zachmorr/f1c200s/hardware/f1c200s.pdf

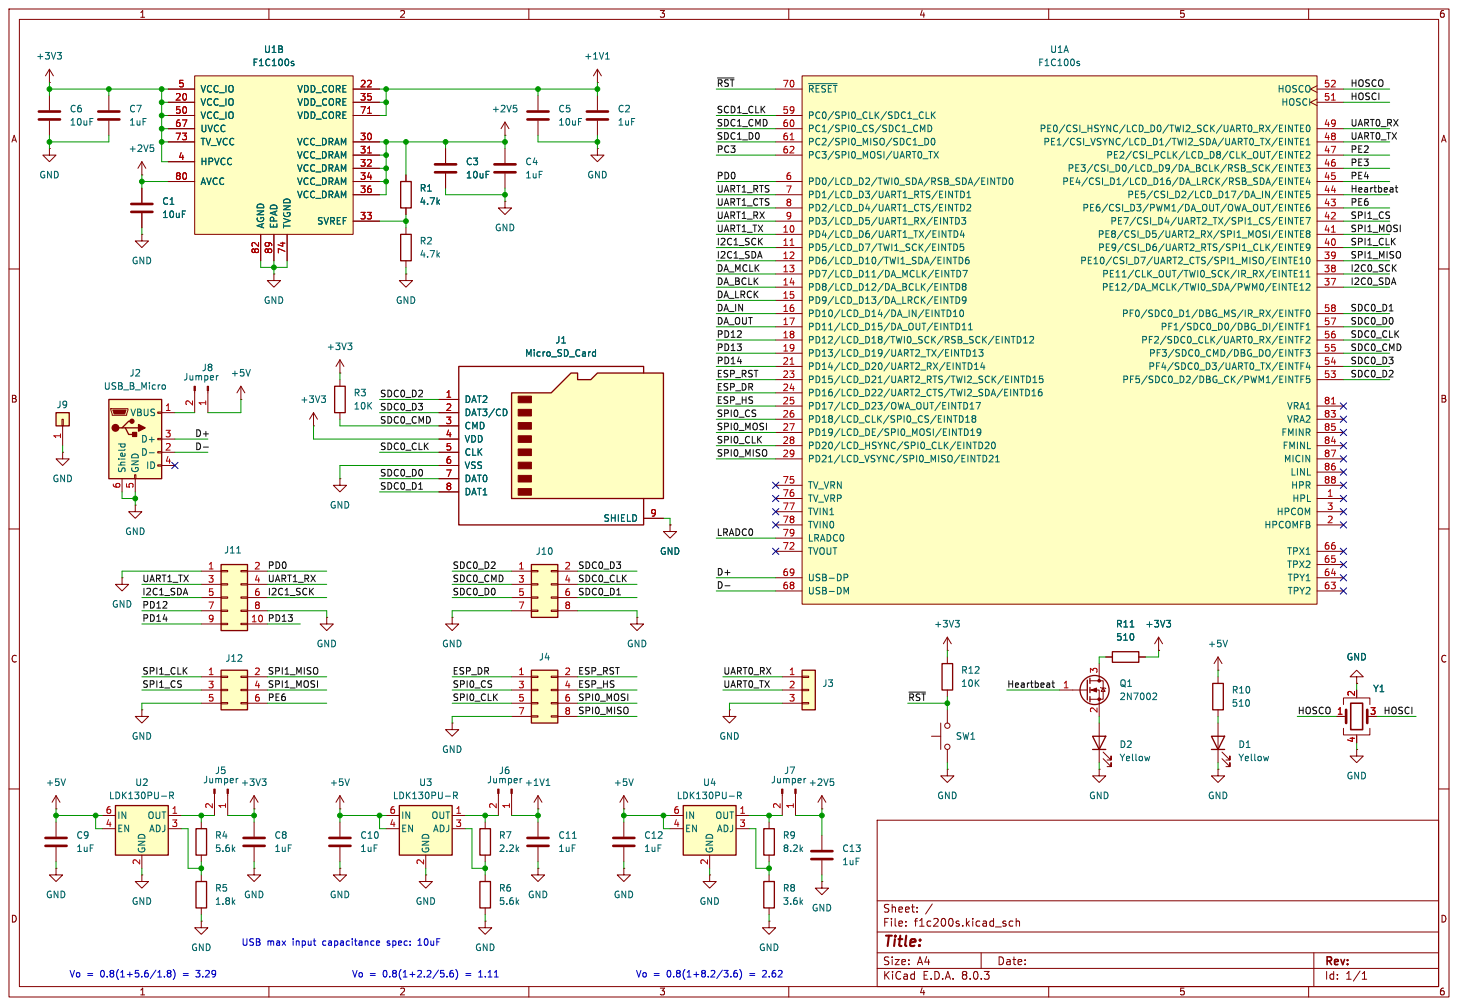
[picture p1: page 1]
