zachmorr/f1c200s/hardware/f1c200s.kicad_pcb

## KiCad design hardware/f1c200s.kicad_pcb (2024-10-19)

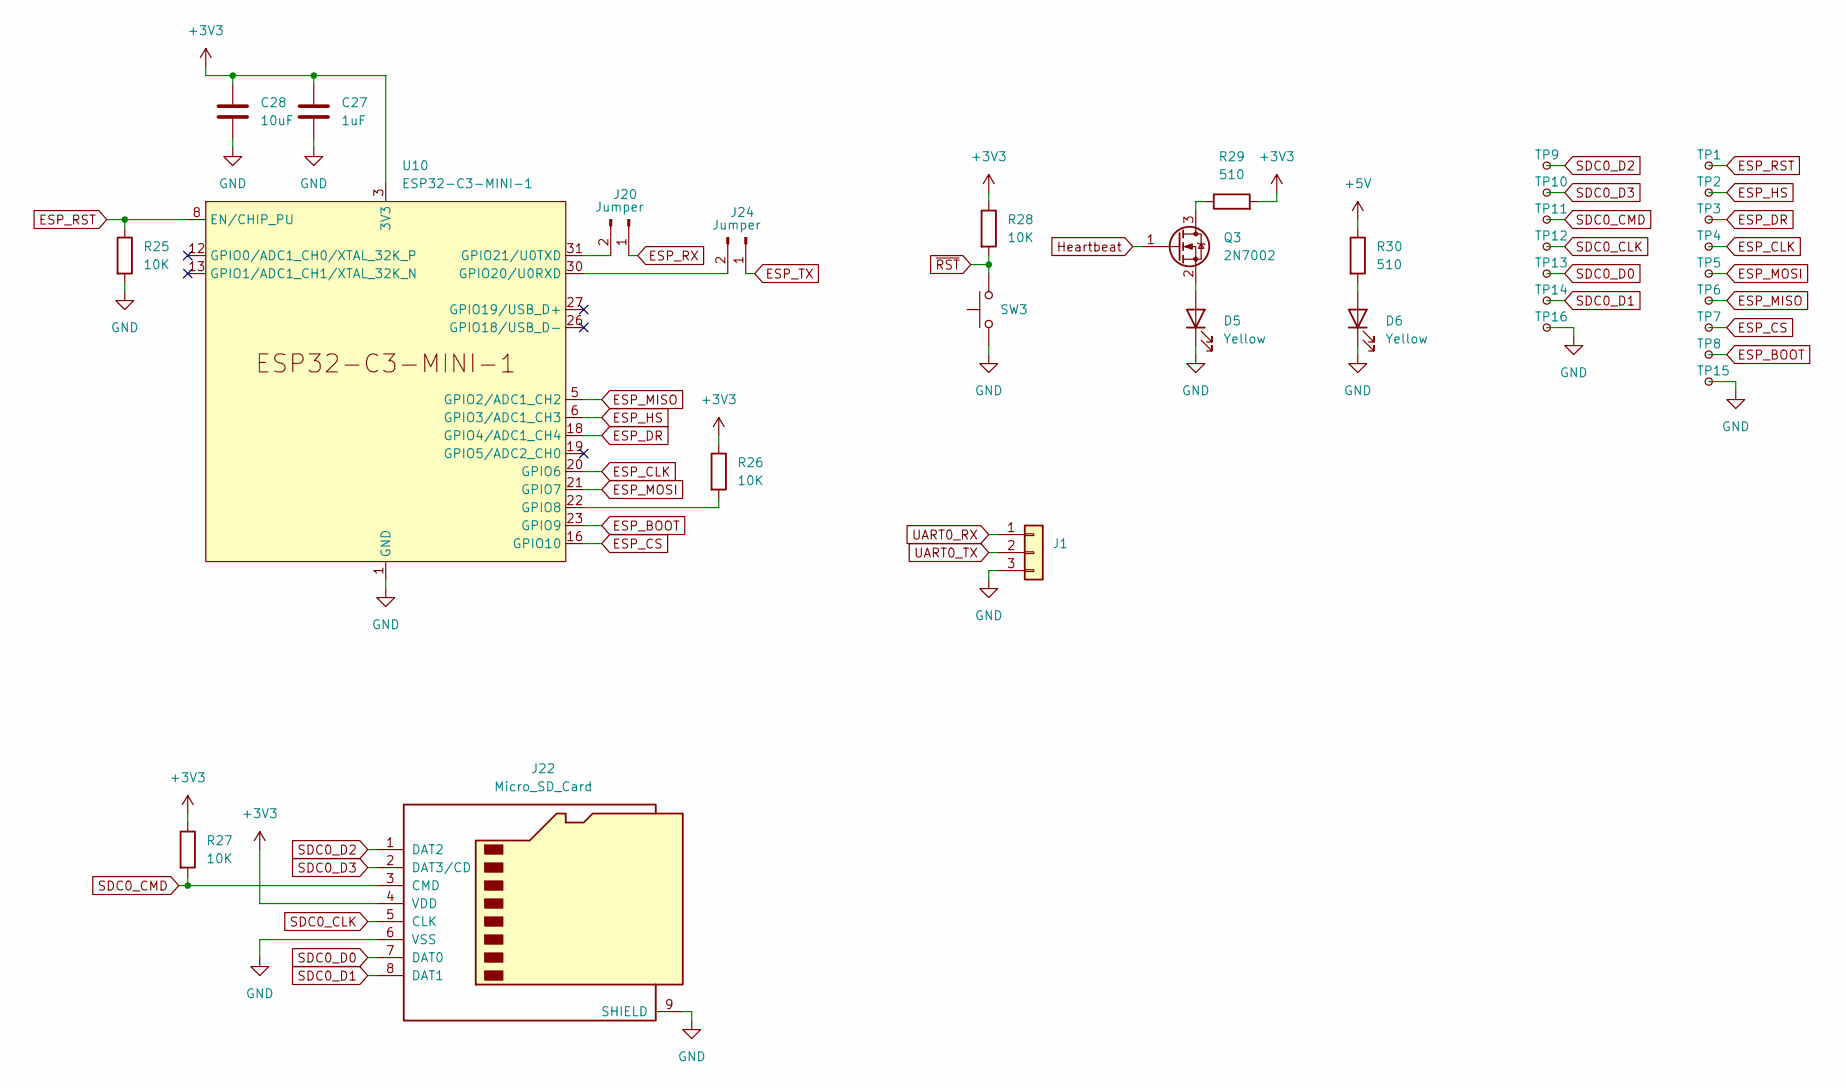
[picture p2: schematic wifi.kicad_sch]

Parts:
C27: 1uF; C_0402_1005Metric; LCSC C52923
C28: 10uF; C_0402_1005Metric; LCSC C15525
D5, D6: Yellow; LED_0603_1608Metric; LCSC C72038
J1: Conn_01x03; PinHeader_1x03_P2.54mm_Vertical
J20, J24: Jumper; PinHeader_1x02_P2.54mm_Vertical
J22: Micro_SD_Card; microSD_HC_Molex_104031-0811; LCSC C585350
Q3: 2N7002; SOT-23; LCSC C8545
R25, R26, R27, R28: 10K; R_0603_1608Metric; LCSC C25804
R29, R30: 510; R_0603_1608Metric; LCSC C23193
SW3: SW_Push; SW_Push_1P1T_XKB_TS-1187A; LCSC C318884
TP1, TP2, TP3, TP4, TP5, TP6, TP7, TP8, TP9, TP10, TP11, TP12, TP13, TP14, TP15, TP16: TestPoint_Small; TestPoint_Pad_D1.0mm
U10: ESP32-C3-MINI-1

Connections:
+3V3: C27.1, C28.1, J22.4 (VDD), R26.1, R27.1, R28.1, R29.2, U10.3 (3V3); also elsewhere on the board
+5V: R30.1; also elsewhere on the board
ESP_BOOT: TP8.1, U10.23 (GPIO9); also elsewhere on the board
ESP_CLK: TP4.1, U10.20 (GPIO6); also elsewhere on the board
ESP_CS: TP7.1, U10.16 (GPIO10); also elsewhere on the board
ESP_DR: TP3.1, U10.18 (GPIO4/ADC1_CH4); also elsewhere on the board
ESP_HS: TP2.1, U10.6 (GPIO3/ADC1_CH3); also elsewhere on the board
ESP_MISO: TP6.1, U10.5 (GPIO2/ADC1_CH2); also elsewhere on the board
ESP_MOSI: TP5.1, U10.21 (GPIO7); also elsewhere on the board
ESP_RST: R25.1, TP1.1, U10.8 (EN/CHIP_PU); also elsewhere on the board
ESP_RX: J20.1; also elsewhere on the board
ESP_TX: J24.1; also elsewhere on the board
GND: C27.2, C28.2, D5.1 (K), D6.1 (K), J1.3, J22.6 (VSS), J22.9 (SHIELD), R25.2, SW3.1, TP15.1, TP16.1, U10.1 (GND), U10.2 (GND), U10.11 (GND), U10.14 (GND), U10.36 (GND), U10.37 (GND), U10.38 (GND), U10.39 (GND), U10.40 (GND), U10.41 (GND), U10.42 (GND), U10.43 (GND), U10.44 (GND), U10.45 (GND), U10.46 (GND), U10.47 (GND), U10.48 (GND), U10.49 (GND), U10.50 (GND), U10.51 (GND), U10.52 (GND), U10.53 (GND); also elsewhere on the board
Heartbeat: Q3.1 (G)
unnamed: D5.2 (A), Q3.2 (S)
unnamed: D6.2 (A), R30.2
unnamed: J20.2, U10.31 (GPIO21/U0TXD)
unnamed: J24.2, U10.30 (GPIO20/U0RXD)
unnamed: Q3.3 (D), R29.1
unnamed: R26.2, U10.22 (GPIO8)
SDC0_CLK: J22.5 (CLK), TP12.1; also elsewhere on the board
SDC0_CMD: J22.3 (CMD), R27.2, TP11.1; also elsewhere on the board
SDC0_D0: J22.7 (DAT0), TP13.1; also elsewhere on the board
SDC0_D1: J22.8 (DAT1), TP14.1; also elsewhere on the board
SDC0_D2: J22.1 (DAT2), TP9.1; also elsewhere on the board
SDC0_D3: J22.2 (DAT3/CD), TP10.1; also elsewhere on the board
UART0_RX: J1.1; also elsewhere on the board
UART0_TX: J1.2; also elsewhere on the board
~RST: R28.2, SW3.2; also elsewhere on the board

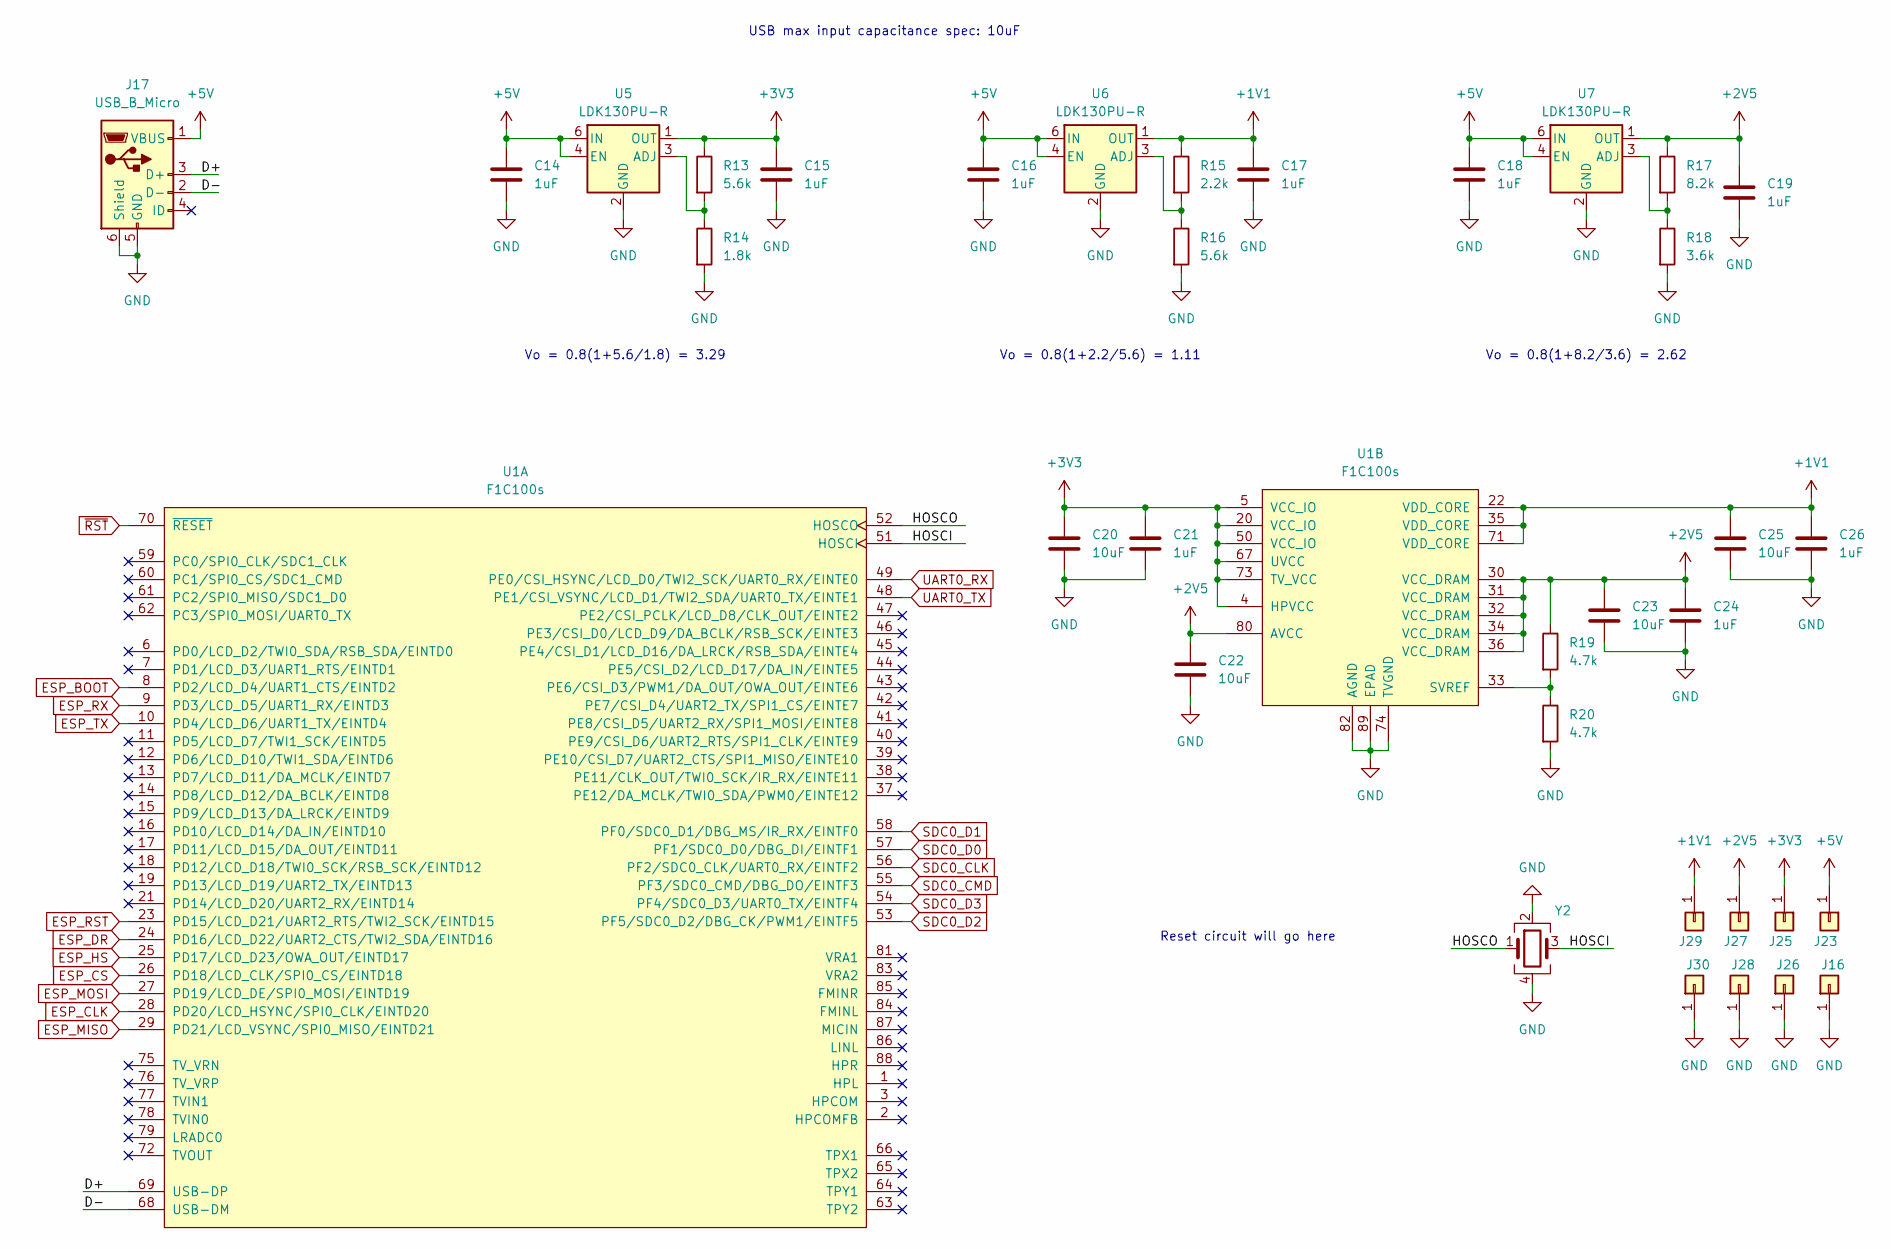
[picture p3: schematic cpu.kicad_sch]

Parts:
C14, C15, C16, C17, C18, C19, C21, C24, C26: 1uF; C_0402_1005Metric; LCSC C52923
C20, C22, C23, C25: 10uF; C_0402_1005Metric; LCSC C15525
J16, J23, J25, J26, J27, J28, J29, J30: Conn_01x01; PinHeader_1x01_P2.54mm_Vertical
J17: USB_B_Micro; USB_Micro-B_Amphenol_10118193-0001LF_Horizontal; LCSC C132562
R13, R16: 5.6k; R_0603_1608Metric; LCSC C23189
R14: 1.8k; R_0603_1608Metric; LCSC C4177
R15: 2.2k; R_0603_1608Metric; LCSC C4190
R17: 8.2k; R_0603_1608Metric; LCSC C25981
R18: 3.6k; R_0603_1608Metric; LCSC C22980
R19, R20: 4.7k; R_0402_1005Metric; LCSC C25900
U1: F1C100s; QFN-88_EP_10x10_Pitch0.4mm
U5, U6, U7: LDK130PU-R; DFN-6_1.3x1.2mm_P0.4mm; LCSC C157446
Y2: XRCGB24M000F0G00R0; Crystal_SMD_2016-4Pin_2.0x1.6mm; LCSC C524653

Connections:
+1V1: C17.1, C25.1, C26.1, J29.1, R15.1, U1.22 (VDD_CORE), U1.35 (VDD_CORE), U1.71 (VDD_CORE), U6.1 (OUT)
+2V5: C19.1, C22.1, C23.1, C24.1, J27.1, R17.1, R19.1, U1.30 (VCC_DRAM), U1.31 (VCC_DRAM), U1.32 (VCC_DRAM), U1.34 (VCC_DRAM), U1.36 (VCC_DRAM), U1.80 (AVCC), U7.1 (OUT)
+3V3: C15.1, C20.1, C21.1, J25.1, R13.1, U1.4 (HPVCC), U1.5 (VCC_IO), U1.20 (VCC_IO), U1.50 (VCC_IO), U1.67 (UVCC), U1.73 (TV_VCC), U5.1 (OUT); also elsewhere on the board
+5V: C14.1, C16.1, C18.1, J17.1 (VBUS), J23.1, U5.4 (EN), U5.6 (IN), U6.4 (EN), U6.6 (IN), U7.4 (EN), U7.6 (IN); also elsewhere on the board
/cpu/D+: J17.3 (D+), U1.69 (USB-DP)
/cpu/D-: J17.2 (D-), U1.68 (USB-DM)
/cpu/HOSCI: U1.51 (HOSCI), Y2.3
/cpu/HOSCO: U1.52 (HOSCO), Y2.1
ESP_BOOT: U1.8 (PD2/LCD_D4/UART1_CTS/EINTD2); also elsewhere on the board
ESP_CLK: U1.28 (PD20/LCD_HSYNC/SPI0_CLK/EINTD20); also elsewhere on the board
ESP_CS: U1.26 (PD18/LCD_CLK/SPI0_CS/EINTD18); also elsewhere on the board
ESP_DR: U1.24 (PD16/LCD_D22/UART2_CTS/TWI2_SDA/EINTD16); also elsewhere on the board
ESP_HS: U1.25 (PD17/LCD_D23/OWA_OUT/EINTD17); also elsewhere on the board
ESP_MISO: U1.29 (PD21/LCD_VSYNC/SPI0_MISO/EINTD21); also elsewhere on the board
ESP_MOSI: U1.27 (PD19/LCD_DE/SPI0_MOSI/EINTD19); also elsewhere on the board
ESP_RST: U1.23 (PD15/LCD_D21/UART2_RTS/TWI2_SCK/EINTD15); also elsewhere on the board
ESP_RX: U1.9 (PD3/LCD_D5/UART1_RX/EINTD3); also elsewhere on the board
ESP_TX: U1.10 (PD4/LCD_D6/UART1_TX/EINTD4); also elsewhere on the board
GND: C14.2, C15.2, C16.2, C17.2, C18.2, C19.2, C20.2, C21.2, C22.2, C23.2, C24.2, C25.2, C26.2, J16.1, J17.5 (GND), J17.6 (Shield), J26.1, J28.1, J30.1, R14.2, R16.2, R18.2, R20.2, U1.74 (TVGND), U1.82 (AGND), U1.89 (EPAD), U5.2 (GND), U6.2 (GND), U7.2 (GND), Y2.2, Y2.4; also elsewhere on the board
unnamed: R19.2, R20.1, U1.33 (SVREF)
unnamed: R13.2, R14.1, U5.3 (ADJ)
unnamed: R15.2, R16.1, U6.3 (ADJ)
unnamed: R17.2, R18.1, U7.3 (ADJ)
SDC0_CLK: U1.56 (PF2/SDC0_CLK/UART0_RX/EINTF2); also elsewhere on the board
SDC0_CMD: U1.55 (PF3/SDC0_CMD/DBG_DO/EINTF3); also elsewhere on the board
SDC0_D0: U1.57 (PF1/SDC0_D0/DBG_DI/EINTF1); also elsewhere on the board
SDC0_D1: U1.58 (PF0/SDC0_D1/DBG_MS/IR_RX/EINTF0); also elsewhere on the board
SDC0_D2: U1.53 (PF5/SDC0_D2/DBG_CK/PWM1/EINTF5); also elsewhere on the board
SDC0_D3: U1.54 (PF4/SDC0_D3/UART0_TX/EINTF4); also elsewhere on the board
UART0_RX: U1.49 (PE0/CSI_HSYNC/LCD_D0/TWI2_SCK/UART0_RX/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); also elsewhere on the board
UART0_TX: U1.48 (PE1/CSI_VSYNC/LCD_D1/TWI2_SDA/UART0_TX/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); also elsewhere on the board
~RST: U1.70 (~RESET); also elsewhere on the board

Notes on the sheet:
Vo = 0.8(1+2.2/5.6) = 1.11
Vo = 0.8(1+5.6/1.8) = 3.29
Vo = 0.8(1+8.2/3.6) = 2.62
USB max input capacitance spec: 10uF
Reset circuit will go here

Board: 4 copper layers, 68 parts (0 on the bottom side), 38 nets, no tracks yet.
