zachmorr/f1c200s/(commit log)

2024-03-25 First version of dev board
    [f1c200s.kicad_pcb, f1c200s.kicad_sch]
2024-04-03 Dev board V2
    [f1c200s.kicad_pcb, f1c200s.kicad_sch]
2024-07-07 re-add bsp
    [genimage.cfg]
2024-08-29 renaming, adding user, removing root, working ssh
    [genimage.cfg]
2024-09-08 Adding 2nd uart + updating esp-hosted patch
2024-09-08 Adding schematic pdf
2024-10-19 Adding ESP32 to board, work in progress
    [IO.kicad_sch, cpu.kicad_sch, f1c200s.kicad_pcb, f1c200s.kicad_sch, peripherals.kicad_sch, wifi.kicad_sch]
2024-10-19 Updating sheet name
    [f1c200s.kicad_sch, peripherals.kicad_sch]
